ITBA-Avionics-Team/FlightComputer/CablingPlan.md

## Componentes
### EasyMini
- 2 cables normales de switch
- 1 cable con ojal a bornera de Drogue
- 1 cable normal al pullpin de Drogue
- 1 cable con ojal a bornera de Main
- 1 cable normal al pullpin de Main

### Entacore AIM
- 2 cables normales para el switch (Los cables de la batería ya los tenemos)
- 1 cable con ojal a bornera de Drogue
- 1 cable con ojal a bornera de Main
- 1 cable normal al pullpin de Drogue
- 1 cable normal al pullpin de Main
- 1 cable normal que conecta el common al pullpin

### Featherweight GPS
- Nada

### Ada FC
- Conector a batería

###
