ITBA-Avionics-Team/FlightComputer/reunion191022.md

# Qué pasó?
Se lanzó el sábado pasado, no se pudo recuperar en el día. Volvieron a ir ayer y no se pudo recuperar tampoco.
No se sabe nada, ni del paracaídas ni nada. Salió 70k ese cohete.

# Dónde estamos?
Va a ser más seguido, más movido, y más acompañado para que se puedan testear bien las cosas y que salgan bien. Vázquez se bajó. 

# A dónde vamos?
Nuevo lanzamiento en febrero, 5cm de diámetro -> 10cm, 1.5m de largo, 1500m de apogeo.
Tenemos que medir: presión, aceleración (p tener redundancia de altitud), almacenar datos leídos (memoria EEPROM por SPI, más confiable porque es más simple el contacto), comunicación con tierra (radio) y GPS, despliegue de paracaídas (a partir de lo propuesto por Miguel). Micro a usar: dos opciones, más potente de lo que necesitamos y usarlo más en un futuro, o usar algo más simple (MCP430).

GPS
Comms x radio + qué se necesita en tierra (cuanto más simple mejor, si se puede comprar algo directamente mejor)
Software de la estación en tierra
Medición barométrica
Medición del acelerómetro
Datos
Elección de micro

Software -> Hardware -> PCB

# Roadmap:
Segunda semana de noviembre tener todo muy avanzado, sensores funcionando, circuitos listos de alim y carga pirotécnica.

# Integración:
En algunos no se puede usar la placa y en otros si. Todo lo que se pueda soldar que vaya soldado. 

# Administrativo
Estamos inscritos, a fines de octubre se ve si estamos o no. Una vez confirmado hay que pagar una inscripción grupal (300usd) e individual (15usd). Actualización en diciembre y quizás otra en marzo. La idea es lanzar el grande el 1ro de mayo. Competencia: fines de junio.
