ITBA-Avionics-Team/FlightComputer/Altium Design/ADA2/ADA2PCB.PcbDoc.htm

Reporting Options

# File in Newer Format

Date | : | 5/6/2023
Time | : | 10:32:38
Filename | : | C:\Users\Agus\Documents\GitHub\FlightComputer\Altium Design\ADA2\ADA2PCB.PcbDoc

Version | Warning
Release 20.0 | CAUTION - Support of propagation delay for primitives

This file was generated by a later version of the software
