ITBA-Avionics-Team/FlightComputer/Altium Design/ADA2/Project Outputs for ADA2/BOM/BOM.xlsx

Designator | Footprint | Value | Manufacturer | Manufacturer Part Number | Supplier | Supplier Part Number | Description | Quantity
C1, C10, C13, C15, C19, C21 | CAPSMD0805 | 1uF | FH (Guangdong Fenghua Advanced Tech) | 0805F105Z250NT | JLCPCB | C285184 | Capacitor SMD 4.7nF | 6
C2, C16 | CAPSMD0805 | 22uF | Samsung Electro-Mechanics | CL21A226KPCLRNC | JLCPCB | C318688 | Capacitor SMD 4.7nF | 2
C3, C4, C5, C6, C7, C9, C12, C14, C17, C18, C20 | CAPSMD0805 | 100nF | FH (Guangdong Fenghua Advanced Tech) | 0805B104M500NT | JLCPCB | C286511 | Capacitor SMD 4.7nF | 11
C8 | CAPSMD0805 | 2.2nF | YAGEO | CC0805JRX7R0BB222 | JLCPCB | C527219 | Capacitor SMD 4.7nF | 1
C11 | CAPSMD0805 | 10nF | PSA(Prosperity Dielectrics) | FN21X103K500PXG | JLCPCB | C525298 | Capacitor SMD 4.7nF | 1
D1, D2, D3 | ESDALC51BT2 |  | STMicroelectronics | ESDALC5-1BT2Y | JLCPCB | C3712112 | ESD Suppressors / TVS Diodes Single Line Transil Vbr 5V min 26pF 0 | 3
D4 | 4-PLCC |  | CREELED, INC. | CLVBA-FKA-CAEDH8BBB7A363 | JLCPCB | C5250259 | Red, Green, Blue _RGB_ 622nm Red, 530nm Green, 470nm Blue LED Indication - Discrete 1.9V Red, 3V Green, 3V Blue 4-PLCC | 1
D5, D6 | LEDSMD0603 |  | Everlight Elec | 19-217/R6C-AL1M2VY/3T | JLCPCB | C72044 | LED SMD Verde | 2
P1, P2 | PZ254V-11-05P |  | XFCN | PZ254V-11-05P | JLCPCB | C492404 | Straight Square Pins 2.5mm 6mm -40℃~+105℃ 3mm 5 2.54mm 单排 Black Brass 1x5P Plugin,P=2.54mm Pin Headers ROHS | 2
P3 | HDR1X6 |  | XFCN | PZ254V-11-06P | JLCPCB | C492405 | Header, 6-Pin | 1
P4 | Micro-B Molex 1051640001 |  | MOLEX | 1050170001 | JLCPCB | C136000 | USB - micro B USB 2.0 Receptacle Connector 5 Position Surface Mount, Right Angle; Through Hole | 1
P5, P6, P8 | BORNERA2 |  | Phoenix Contact | 1727010 | JLCPCB | C89123 | 13.5A 200V Green Straight pin 3.81mm 1 2 Plugin,P=3.81mm Screw terminal ROHS | 3
P7 | JST_BM02B-GHS-TBT(LF)(SN) |  | JST Sales America | BM02B-GHS-TBT(LF)(SN) | JLCPCB | C161690 | Connector Header Surface Mount 2 position 0.049 (1.25mm) | 1
Q1, Q2 | SOT-23-3 |  | JSMSEMI | S8050 | JLCPCB | C916390 | 25V 300mW 500mA SOT-23 Bipolar Transistors - BJT ROHS | 2
Q3 | TRANS_TSM200N03DPQ33_RGG |  | Taiwan Semiconductor Corporation | TSM200N03DPQ33 RGG | Digikey | TSM200N03DPQ33RGGCT-ND | MOSFET 2 N-CH 30V 20A 8PDFN | 1
R1, R10, R13, R16, R17, R19, R20 | 0805 | 470R | UNI-ROYAL(Uniroyal Elec) | CQ05W8J0471T5E | JLCPCB | C473621 | Resistencia SMD 470ohms | 7
R2, R3, R4, R5, R6, R7, R8, R9, R14, R15 | 0805 | 10K | Viking Tech | ARG05BTC1002 | JLCPCB | C406725 | Resistencia SMD 470ohms | 10
R11, R12 | 0805 | 4K7 | Viking Tech | CR-05FL7---4K7 | JLCPCB | C280006 | Resistencia SMD 470ohms | 2
R18 | 0805 | 1M | YAGEO | RC0805FR-071ML | JLCPCB | C107700 | Resistencia SMD 470ohms | 1
R21 | 0805 | 22K | KOA Speer Elec | RN73H2ATTD2202B25 | JLCPCB | C186285 | Resistencia SMD 470ohms | 1
R22 | 0805 | 47K | Sunway | SC0805J4702F4ANRH | JLCPCB | C3152235 | Resistencia SMD 470ohms | 1
S1, S2 | PUSHBUTTON_2 |  | C&K | PTS645SM43SMTR92LFS | JLCPCB | C221880 | SWITCH TACTILE SPST-NO 0.05A 12V | 2
TP1, TP2, TP3, TP4, TP5, TP6 | 5015 |  | Ronghe | RH-5015 | JLCPCB | C5199798 | Thimble/Copper Rod/Test Ring ROHS | 6
U1 | XCVR_ESP32-WROOM-32E_(16MB) |  | Espressif Systems | ESP32-WROOM-32E-N16 | JLCPCB | C701343 | Bluetooth, WiFi 802.11b/g/n, Bluetooth v4.2 +EDR, Class 1, 2 and 3 Transceiver Module 2.4GHz ~ 2.5GHz Integrated, Trace Surface Mount | 1
U2 | QFN24 |  | TDK InvenSense | MPU-6050 | JLCPCB | C24112 | MPU-6050 series Accelerometer, Gyroscope, 3 Axis Sensor Evaluation Board | 1
U3 | CP2102N |  | SILICON LABS | CP2102N-A02-GQFN28R | JLCPCB | C964632 | USB Interface IC USB to UART bridge - QFN28 | 1
U4 | SOIC127P790X216-8N |  | Winbond Elec | W25Q80DVSSIG | JLCPCB | C14086 | 8M-bit 3.0V Serial Flash Memory with uniform 4KB sectors and Dual/Quad SPI | 1
U5 | BMP390 |  | BOSCH | BMP390 | JLCPCB | C5124834 | Board Mount Pressure Sensors | 1
U6 | SON65P200X200X80-7N |  | Texas Instruments | LP5912-3.3DRVT | JLCPCB | C134121 | 500-mA, low-noise, low-IQ, low-dropout voltage regulator with reverse current protection 6-WSON -40 to 125 | 1
