ITBA-Avionics-Team/FlightComputer/Altium Design/ADA2/WIN_SS-8_WIN.step

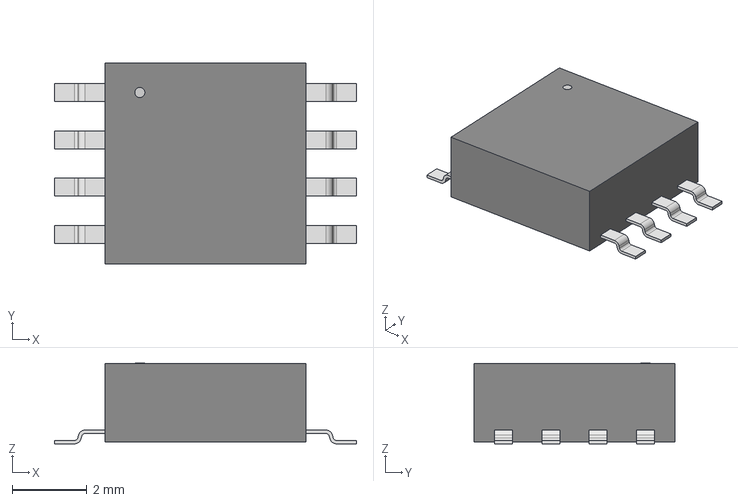
[picture p1: CAD file, 2023-05-26]
Altium Design/ADA2/WIN_SS-8_WIN.step
8.10 x 5.38 x 2.16 mm
