ITBA-Avionics-Team/FlightComputer/Altium Design/ADA2/SOD882.step

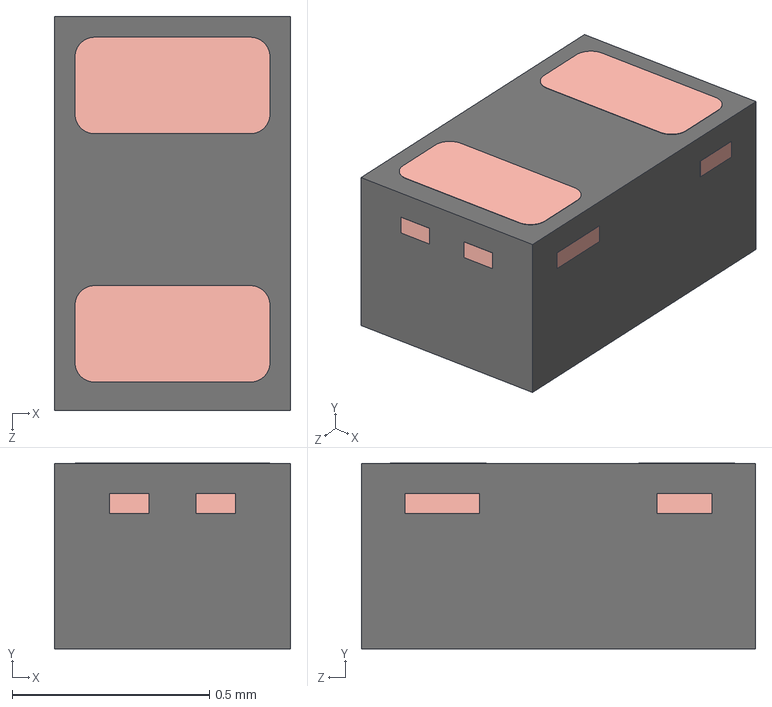
[picture p2: CAD file, 2023-05-26]
Altium Design/ADA2/SOD882.step
0.6 x 0.471 x 1.00 mm
SOD882 body
SOD882A3 singulated LF unit
