ITBA-Avionics-Team/FlightComputer/Altium Design/ADA2/LP5912-3.3DRVT.STEP

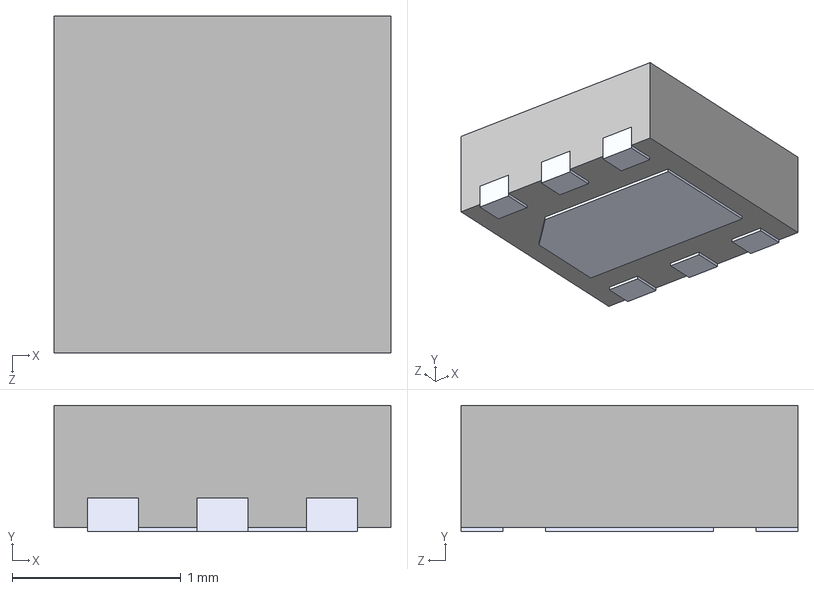
[picture p3: CAD file, 2023-05-26]
Altium Design/ADA2/LP5912-3.3DRVT.STEP
2.00 x 0.75 x 2.00 mm
