ITBA-Avionics-Team/FlightComputer/Altium Design/ADA2/ADA2PCB.step

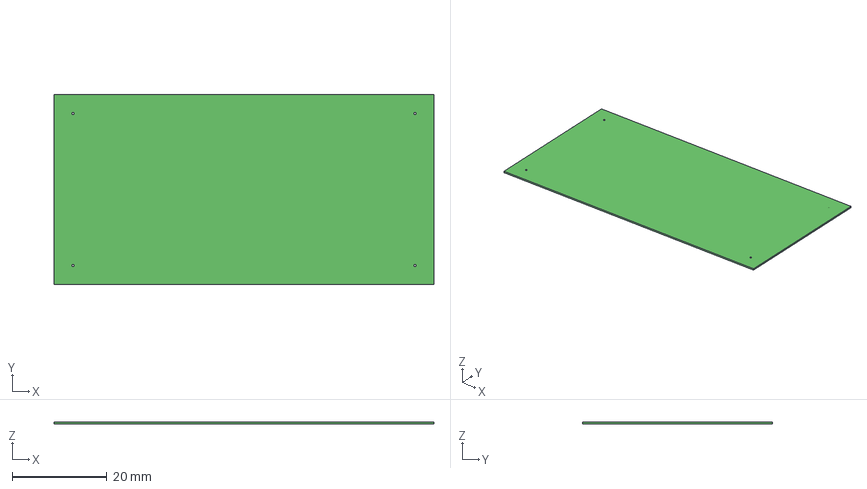
[picture p4: CAD file, 2023-05-26]
Altium Design/ADA2/ADA2PCB.step
80.0 x 40.0 x 0.411 mm
