ITBA-Avionics-Team/FlightComputer/Altium Design/ADA2/BMP390.step

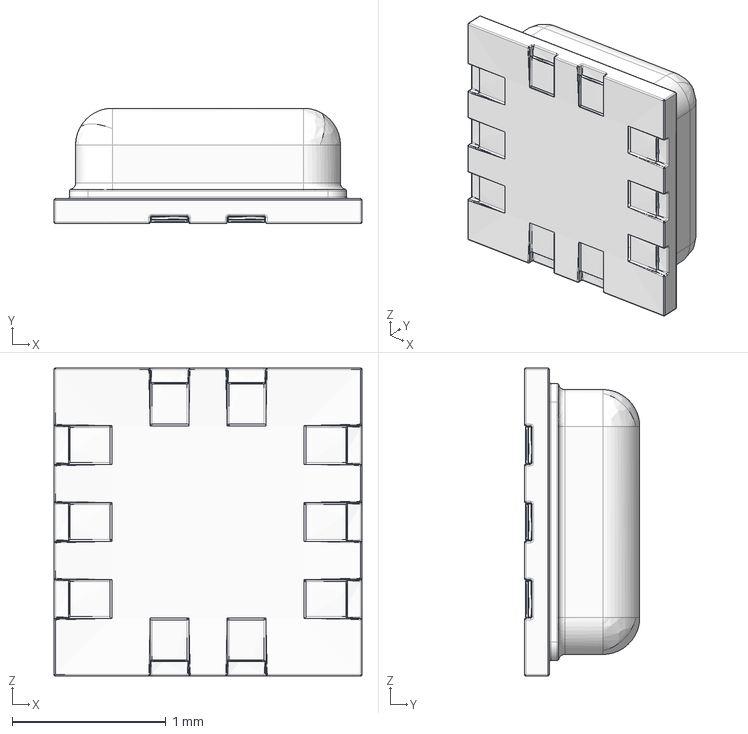
[picture p5: CAD file, 2023-05-26]
Altium Design/ADA2/BMP390.step
2.00 x 0.75 x 2.00 mm
