ITBA-Avionics-Team/FlightComputer/Altium Design/ADA2/1051640001--3DModel-STEP-56544.STEP

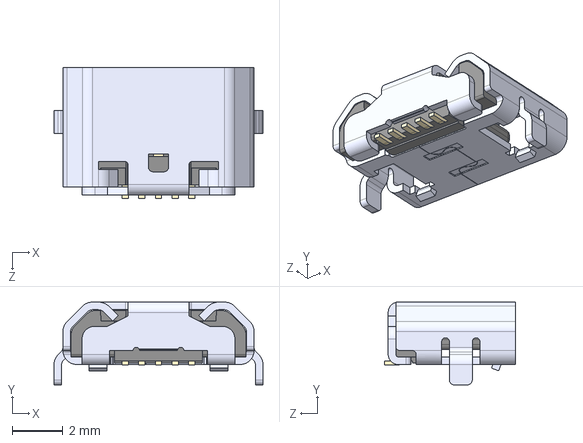
[picture p6: CAD file, 2023-05-26]
Altium Design/ADA2/1051640001--3DModel-STEP-56544.STEP
8.20 x 3.25 x 5.15 mm
