ITBA-Avionics-Team/FlightComputer/Altium Design/ADA2/Project Outputs for ADA2/PCB 3D Print/PCB 3D Print BOT.png

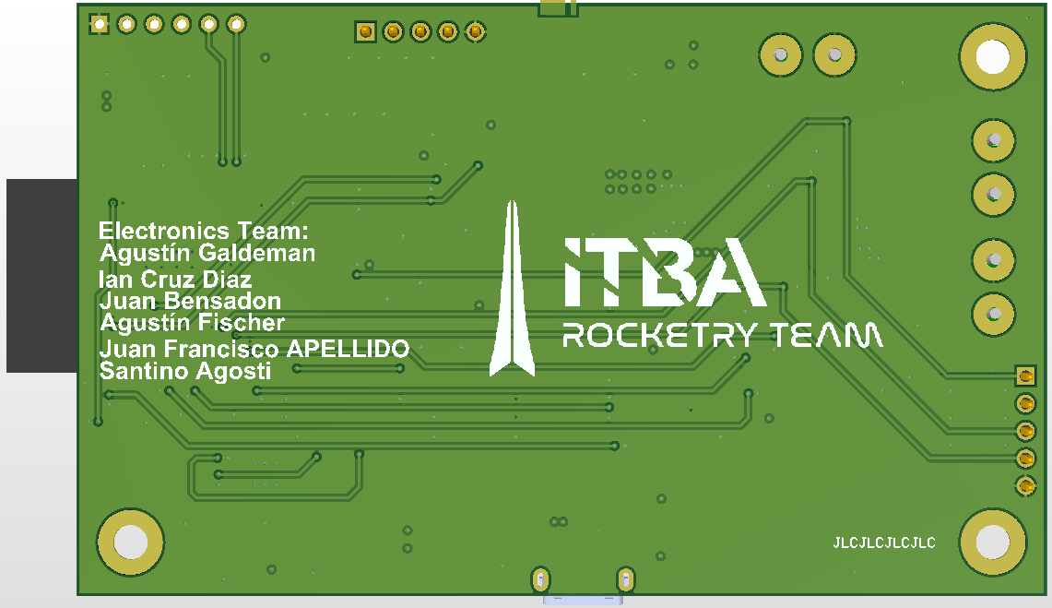
Altium Design/ADA2/Project Outputs for ADA2/PCB 3D Print/PCB 3D Print BOT.png
