ITBA-Avionics-Team/FlightComputer/Final Launch/test/KallmanFilterTest/pressure_data.csv

measured | filtered
100833 | 50416
100833 | 100733
100833 | 100832
100833 | 100832
100833 | 100832
100833 | 100832
100833 | 100832
100833 | 100832
100833 | 100832
100833 | 100832
100833 | 100832
100833 | 100832
100833 | 100832
98522 | 100631
97353 | 98411
96081 | 96178
95049 | 95095
94231 | 94298
93621 | 93689
93137 | 93206
92812 | 92870
92578 | 92634
92645 | 92642
92868 | 92745
92756 | 92751
92924 | 92820
92913 | 92868
93059 | 92963
93115 | 93053
93216 | 93150
93250 | 93211
93384 | 93306
93441 | 93387
97539 | 95814
93655 | 93738
93700 | 93701
93790 | 93752
93880 | 93818
93948 | 93888
94072 | 93990
94378 | 94227
94231 | 94230
94299 | 94260
94378 | 94310
94503 | 94402
94617 | 94528
94651 | 94607
94810 | 94727
96334 | 95757
94947 | 95014
95015 | 95014
95118 | 95063
95278 | 95168
95323 | 95262
98264 | 97083
95495 | 95575
95587 | 95586
95678 | 95633
95782 | 95707
95862 | 95792
96127 | 95988
96023 | 96013
96069 | 96040
96150 | 96088
96207 | 96144
96288 | 96217
96357 | 96294
96438 | 96376
96519 | 96459
96623 | 96555
96669 | 96624
96738 | 96688
96831 | 96766
96900 | 96842
96981 | 96921
97121 | 97036
97179 | 97126
97190 | 97165
97295 | 97229
97341 | 97289
97458 | 97378
97598 | 97507
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
