ITBA-Avionics-Team/FlightComputer/Final Launch/TODO.md

# TODO
### SensorModule:
- Implement BMP390 interface and define pins
- Implement MPU6050 interface and define pins
- Implement Winbond W25Q80 interface and define pins??
- Run SensorModuleTest to verify
### ElectromechanicalModule:
- Define Pyro pins for drogue and main parachutes
- Run ElectromechanicalModuleTest to verify
### StorageModule
- Test retrieving of data from flash memory

### MainModule
- Run MainModuleTest with simulation data.
