ITBA-Avionics-Team/FlightComputer/Altium Design/ADA2/Project Outputs for ADA2/Schematic Prints.PDF

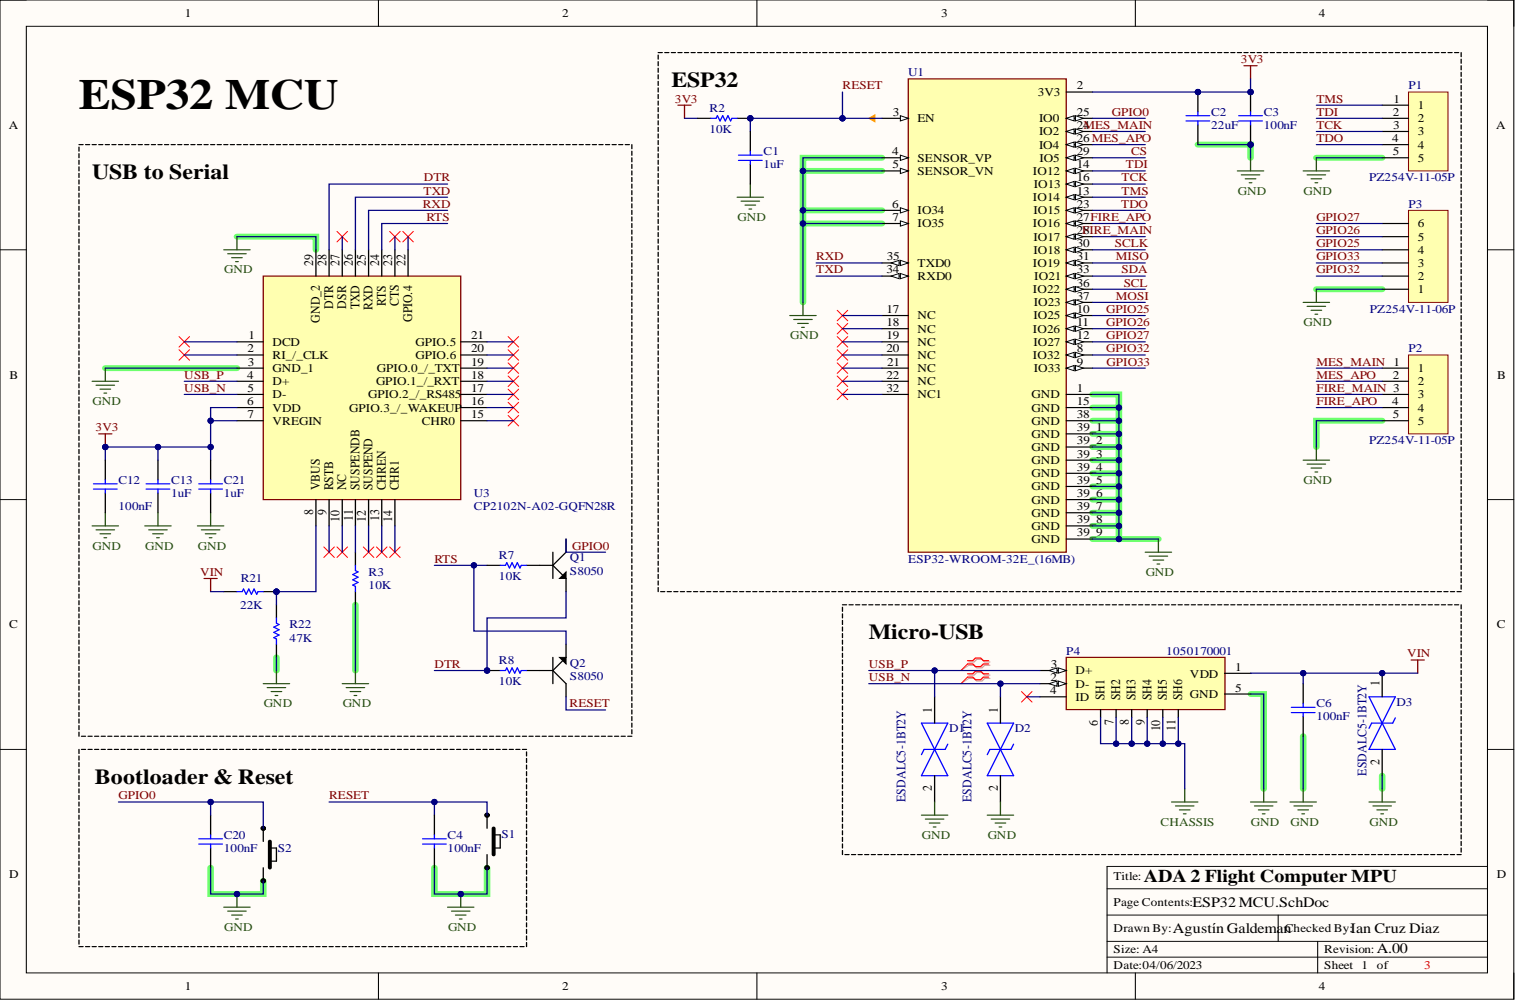
[picture p10: page 1]

TMS TDI TCK TDO

3 9 | _ 2
3 9 | _ 3
3 9 | _4
3 9 | _ 5
3 9 | _ 6

3 9 | _ 7
3 9 | _ 8
3 9 | _ 9

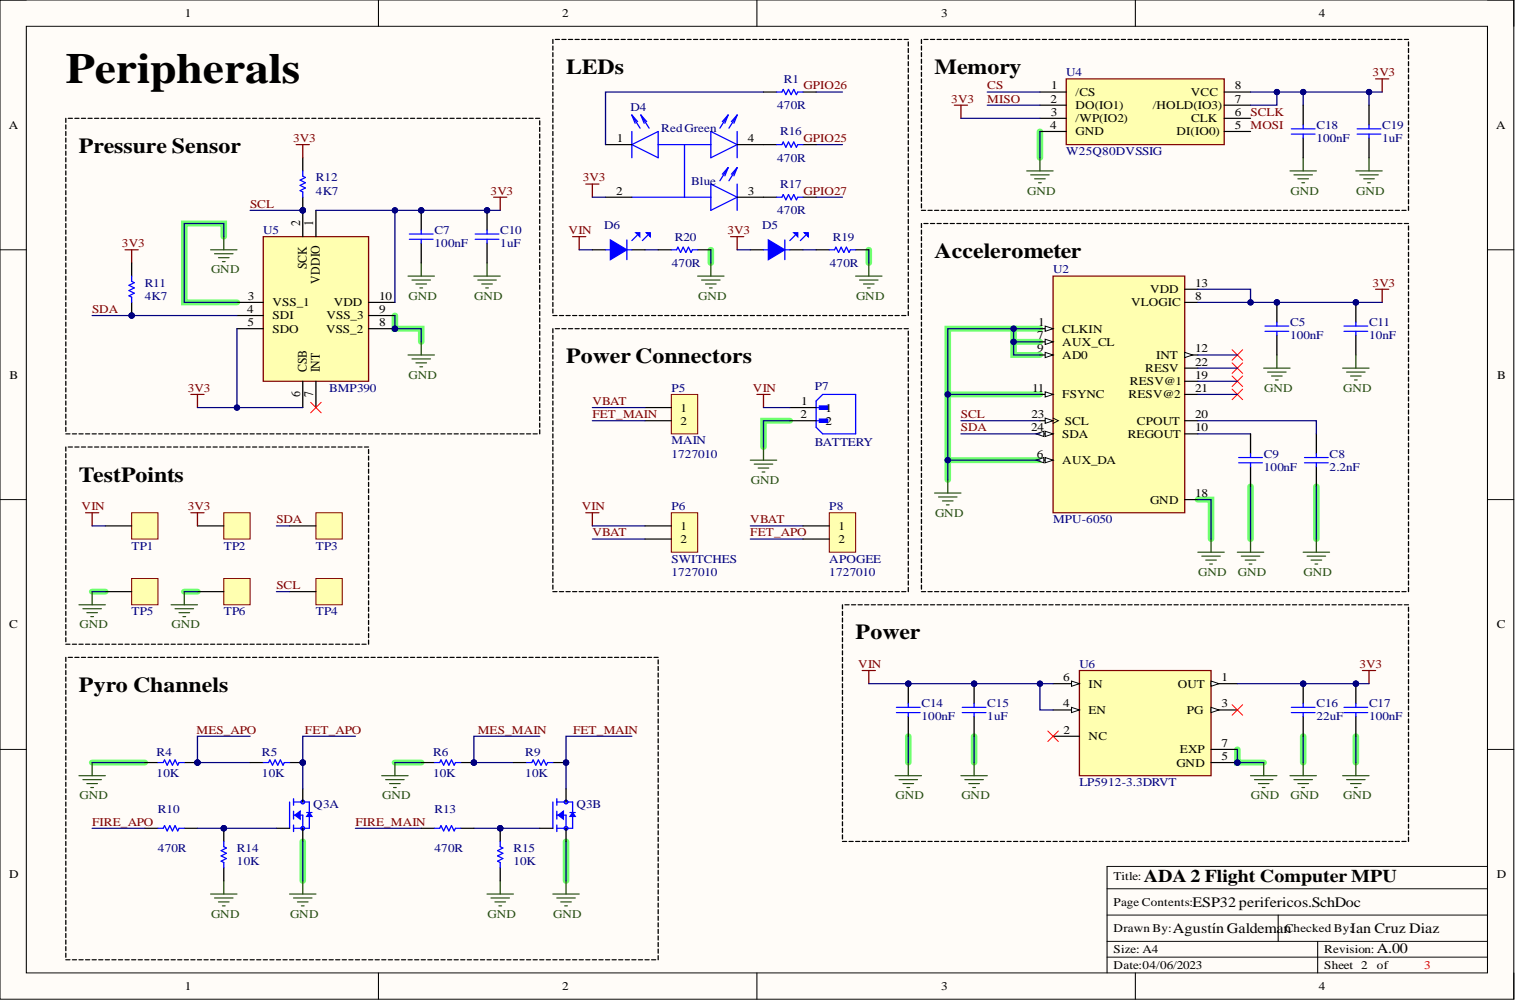
[picture p11: page 2]

ADA 2 Flight Computer MPU
Title:

Page Contents:ESP32 perifericos.SchDoc

Drawn By:Agustín GaldemanChecked By:Ian Cruz Diaz

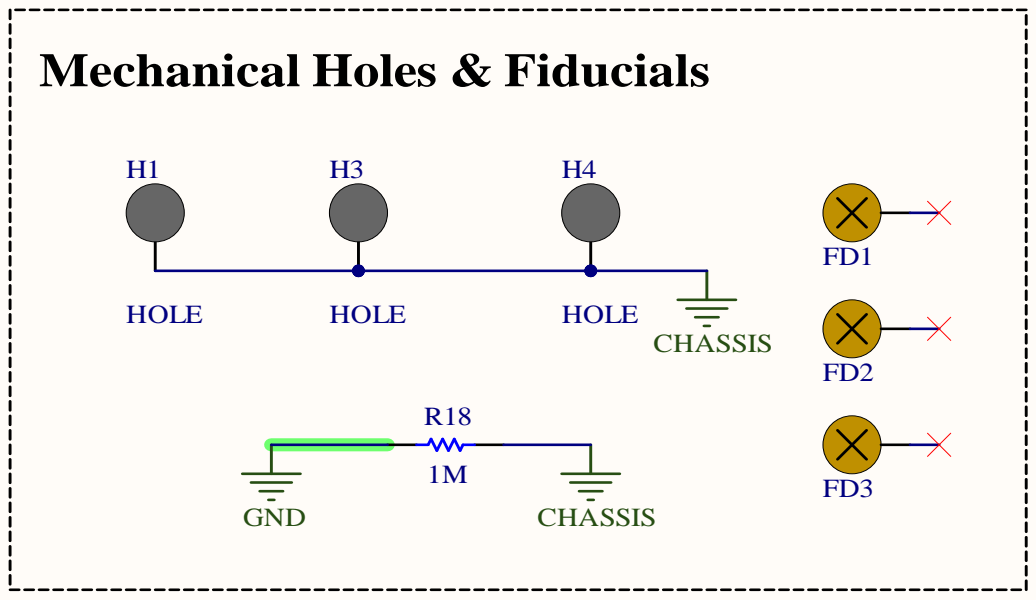
[picture p12: page 3]

ADA 2 Flight Computer MPU
Title:

Page Contents:Mounting.SchDoc

Drawn By:Agustín GaldemanChecked By:Ian Cruz Diaz
