ITBA-Avionics-Team/FlightComputer/(list of files, drawings)

Other design files:
Altium Design/ADA2/ADA2.PrjPcb
Altium Design/ADA2/ADA2PCB.PcbDoc
Altium Design/ADA2/ESP32 MCU.SchDoc
Altium Design/ADA2/ESP32 perifericos.SchDoc
Altium Design/ADA2/ESP32 Platform.PcbLib
Altium Design/ADA2/ESP32 Platform.SchLib
Altium Design/ADA2/ESp32.SchDoc
Altium Design/ADA2/Mounting.SchDoc
Altium Design/ADA2/Passive Components.PcbLib
Altium Design/ADA2/Passive Components.SchLib
