ITBA-Avionics-Team/FlightComputer/Final Launch/main/ElectromechanicalModule.h

#define PYRO_PIN_DROGUE 0
#define PYRO_PIN_MAIN 0

#define GREEN_PIN 0
#define RED_PIN 0

class ElectromechanicalModule {
  bool drogueDeployed = false;
  bool mainDeployed = false;

  public:

    void init() { 
      // pinMode(GREEN_PIN, OUTPUT);
      // pinMode(RED_PIN, OUTPUT);
      pinMode(PYRO_PIN_DROGUE, OUTPUT);
      pinMode(PYRO_PIN_MAIN, OUTPUT);
      Logger::log("Electromechanical Module initialized.");
    }

    void deployDrogueParachute() {
      Logger::log("Deploying drogue parachute...");
      
      // digitalWrite(GREEN_PIN, !digitalRead(GREEN_PIN));
      // delay(500);
      // digitalWrite(GREEN_PIN, !digitalRead(GREEN_PIN));
      
      digitalWrite(PYRO_PIN_DROGUE, HIGH); //FIRE!
      drogueDeployed = true;
      Logger::log("Charges fired, drogue parachute deployed!");
    }

    void deployMainParachute() {
      Logger::log("Deploying main parachute...");
      
      // digitalWrite(GREEN_PIN, !digitalRead(RED_PIN));
      // delay(500);
      // digitalWrite(GREEN_PIN, !digitalRead(RED_PIN));
      
      digitalWrite(PYRO_PIN_MAIN, HIGH); //FIRE!
      mainDeployed = true;
      Logger::log("Charges fired, main parachute deployed!");
    }

};
