ITBA-Avionics-Team/FlightComputer/Final Launch/main/KalmanFilter.h

/*
 * SimpleKalmanFilter - a Kalman Filter implementation for single variable models.
 * Created by Denys Sene, January, 1, 2017.
 * Released under MIT License - see LICENSE file for details.
 */

#ifndef KALMANFILTER_H
#define KALMANFILTER_H

class KalmanFilter
{

public:
  KalmanFilter(float mea_e, float est_e, float q);
  float updateEstimate(float mea);
  void setMeasurementError(float mea_e);
  void setEstimateError(float est_e);
  void setProcessNoise(float q);
  float getKalmanGain();
  float getEstimateError();

private:
  float _err_measure;
  float _err_estimate;
  float _q;
  float _current_estimate;
  float _last_estimate;
  float _kalman_gain;

};

#endif
