ITBA-Avionics-Team/FlightComputer/Final Launch/test/StorageModuleTest/StorageModuleTest.ino

#include "Logger.h"
#include "StorageModule.h"


StorageModule storageModule = StorageModule();

void setup(){
  Serial.begin(9600);
  Logger::log("Initializing storage module");
  storageModule.init();

  // testSaveCurrentState();
  testLoadCurrentState();
  // testAddTelemetryPacketToFlightLog();
  // testSaveTelemetryPacketCount();
  testLoadTelemetryPacketCount();

}

void loop() {
  testSaveCurrentState();
  delay(1000);
  testLoadCurrentState();
  delay(1000);
  testAddTelemetryPacketToFlightLog();
  delay(1000);
  testSaveTelemetryPacketCount();
  delay(1000);
  testLoadTelemetryPacketCount();
  delay(1000);
}

void testSaveCurrentState() {
  Logger::log("Testing saveCurrentState()...");
  uint8_t currentStateTestValue = 42;
  storageModule.saveCurrentState(currentStateTestValue);
  Logger::log("Saved state " + String(currentStateTestValue));
}

void testLoadCurrentState() {
  Logger::log("Testing loadCurrentState()...");
  uint8_t defaultCurrentState = 13;
  uint8_t loadedState = storageModule.loadCurrentState(defaultCurrentState);
  Logger::log("Loaded state " + String(loadedState));
}

void testAddTelemetryPacketToFlightLog() {
  Logger::log("Testing addTelemetryPacketToFlightLog()...");
  char* telemetryPacketTestValue = "10000,ST,9999,42.30402,34.30402";
  storageModule.addTelemetryPacketToFlightLog(telemetryPacketTestValue);
  Logger::debug("Saved telemetry packet to storage: " + String(telemetryPacketTestValue));
}

void testSaveTelemetryPacketCount() {
  Logger::log("Testing saveTelemetryPacketCount()...");
  uint8_t telemPacketCountTestValue = 1202;
  storageModule.saveTelemetryPacketCount(telemPacketCountTestValue);
  Logger::log("Saved telemetry package count " + String(telemPacketCountTestValue));
}

void testLoadTelemetryPacketCount() {
  Logger::log("Testing loadTelemetryPacketCount()...");
  uint8_t loadedTelPacketCount = storageModule.loadTelemetryPacketCount();
  Logger::log("Loaded packet count " + String(loadedTelPacketCount));
}

    
