ITBA-Avionics-Team/FlightComputer/(commit log)

2022-10-12 cambios de prueba pyro charge
2022-12-05 Added Sensor module
2022-12-06 Fixed bugs, added logger, tidied code, tested on Wemos D1 Mini (ESP8266)
    [ElectromechanicalModule.h, KalmanFilter.cpp, KalmanFilter.h, Logger.h, Queue.cpp, Queue.h, SensorModule.h, StorageModule.h]
2022-12-10 Fixed switch state to post_apogee
    [main.ino]
2023-01-20 Added test for the main module using simulated pressure values for altitude sensing
2023-01-21 Added launch, apogee and landing detection to main flight script
2023-05-26 added pcb
    [1051640001--3DModel-STEP-56544.STEP, ADA2.PrjPcb, ADA2PCB.PcbDoc, ADA2PCB.step, BMP390.step, ESP32 MCU.SchDoc, ESP32 Platform.SchLib, ESP32 perifericos.SchDoc]
2023-05-26 arreglado libreria faltante
    [ADA2.PrjPcb, ESP32 Platform.PcbLib]
2023-05-26 latest revision
    [ADA2PCB.PcbDoc]
2023-05-26 added some 3d models
    [ADA2PCB.PcbDoc, ESP32 Platform.PcbLib, WIN_SS-8_WIN.step]
2023-05-27 fixed issues, general improvements
    [ADA2.PrjPcb, ADA2PCB.PcbDoc, ESP32 MCU.SchDoc, ESP32 Platform.SchLib, ESP32 perifericos.SchDoc]
2023-06-04 fix: Schematic
    Se emprolijo mucho el esquematico y se cambiaron los templates de las
    hojas de esquematico
    [ADA2.PrjPcb, ESP32 MCU.SchDoc, ESP32 perifericos.SchDoc, Mounting.SchDoc]
2023-06-04 fix: Cambio el modelo de Pushbutton
    Cambio el pushbutton y hago que todas las vias queden tented, asi no
    molestan con el silkscreen
    [ADA2PCB.PcbDoc, ESP32 MCU.SchDoc]
2023-06-04 fix: XCheck issues
    Se corrigieron los siguientes issues:
    - Se cambio el modelo de los pushbuttons
    - Se arreglaron rules mal configuradas
    - Minor corrections over PCB
    [ADA2PCB.PcbDoc]
2023-06-04 fix: general adjustemenst pcb
    [ADA2.PrjPcb, ESP32 MCU.SchDoc, ESP32 perifericos.SchDoc]
2023-06-04 fix: PCB XCheck
    Agregue fiduciales y vias, mas cambios menores
    [Mounting.SchDoc]
2023-06-04 fix: Agrego outjob
    [ADA2.PrjPcb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]
2023-06-04 fix: Started adding parameters to components
    [ESP32 MCU.SchDoc, ESP32 perifericos.SchDoc]
2023-06-04 fix: Parameters for components and regenerated outputs
    [ADA2PCB_Copper_Signal_1.gbr, ADA2PCB_Copper_Signal_2.gbr, ADA2PCB_Copper_Signal_Bot.gbr, ADA2PCB_Copper_Signal_Top.gbr, ADA2PCB_Legend_Bot.gbr, ADA2PCB_Legend_Top.gbr, ADA2PCB_NPTH_Drill.gbr, ADA2PCB_PTH_Drill.gbr]
2023-06-04 fix: outjobs for bom and pickplace
    [ADA2PCB_Copper_Signal_1.gbr, ADA2PCB_Copper_Signal_2.gbr, ADA2PCB_Copper_Signal_Bot.gbr, ADA2PCB_Copper_Signal_Top.gbr, ADA2PCB_Legend_Bot.gbr, ADA2PCB_Legend_Top.gbr, ADA2PCB_NPTH_Drill.gbr, ADA2PCB_PTH_Drill.gbr]
2023-06-18 Added initial files or final launch, some modifications already done, still work missing
    [pressure_data.csv]
2023-06-18 Added non-volatile packet count storage to Storage Module, removed unnecessary code, finished correcting MainModule
    [ElectromechanicalModule.h, KalmanFilter.cpp, KalmanFilter.h, Logger.h, MainModuleTest.ino, MockStorageModule.h, Queue.cpp]
2023-06-18 Commented out gps code from mock sensor module
2023-06-18 Fixed compilation errors. Tests are ready to be launched.
    [ElectromechanicalModule.h, KalmanFilter.cpp, KalmanFilter.h, MockSensorModule.h, SensorModule.h, StorageModule.h]
2023-06-18 Added TODO, readded Kalman Filter to SensorModule, added SensorModuleTest and ElectromechanicalModuleTest
2023-06-18 Improved pressure plotting script used in kalman filter test
2023-06-20 Added storage capacity test
